monoastro/godspeed/extras/5f075b080c7758b0ab2cda3ce8750554.jpg

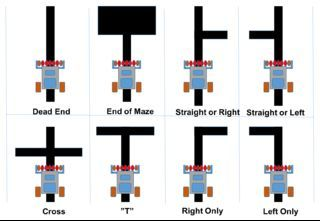
extras/5f075b080c7758b0ab2cda3ce8750554.jpg
