monoastro/godspeed/extras/Capture-3.webp

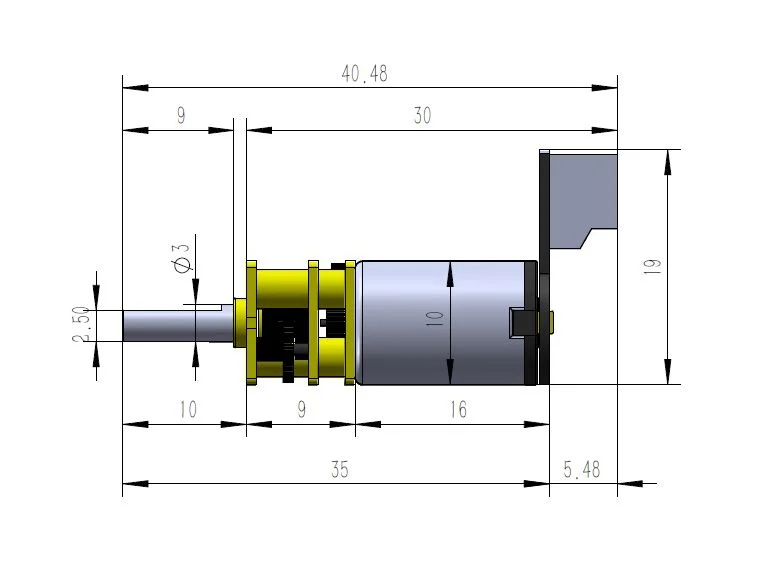
extras/Capture-3.webp
