monoastro/godspeed/extras/N20-micro-gear-motor-dimensions.webp

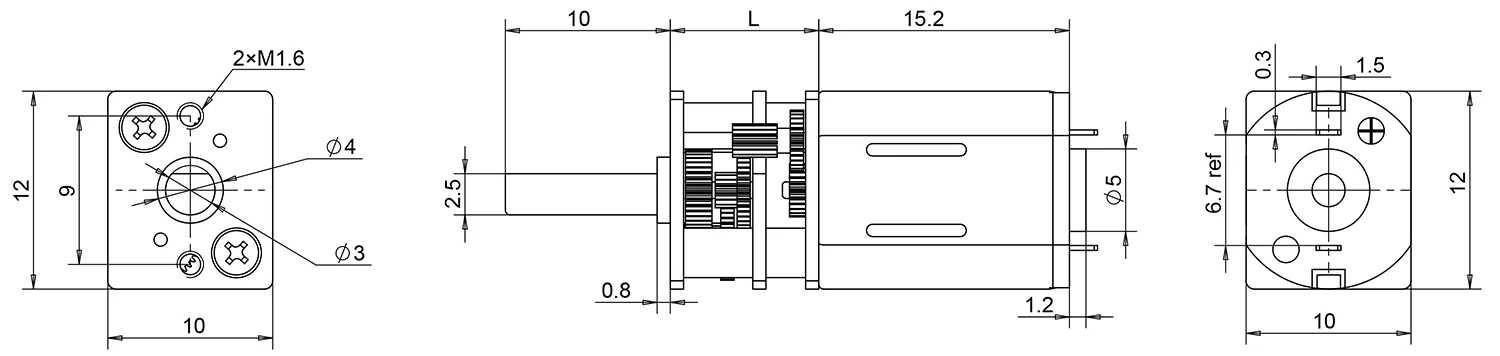
extras/N20-micro-gear-motor-dimensions.webp
