monoastro/godspeed/extras/premium-n20-gear-motor-501-ratio-460-rpm-w--encoder-dime.jpg

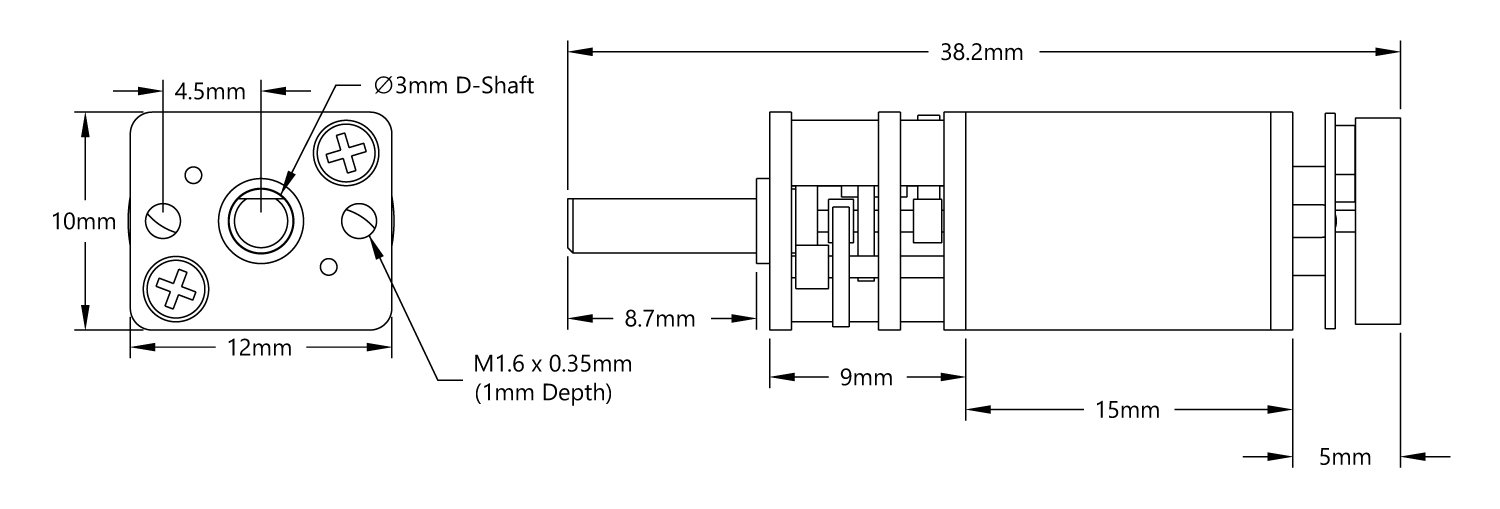
extras/premium-n20-gear-motor-501-ratio-460-rpm-w--encoder-dime.jpg
