monoastro/godspeed/extras/cost estimation final.xlsx

Sheet: Sheet1
Name of the Components | Quantity | Price per unit | Total Price
40 Amp BLDC Esc | 5 | 1100 | 5500
10 inch drone propeller | 10 | 120 | 1200
Flysky 6 channel reciever | 5 | 1000 | 5000
Servo tester | 5 | 300 | 1500
3s Li-po Battery 12V (2200 mAh) | 2 | 4500 | 9000
3s Li-po Battery 12V (3300 mAh) | 3 | 5000 | 15000
SG 90 Micro servo motor | 12 | 270 | 3240
MG90s metal gear mini servo motor | 15 | 415 | 6225
MG996s metal gear mini servo motor | 3 | 700 | 2100
Arduino Nano with connector | 10 | 850 | 8500
ESP 32 s3 with connector | 5 | 950 | 4750
Micro N20 gear mmotor (300 rpm) with wheel | 15 | 500 | 7500
12V DC gear motor (500 rpm) | 5 | 600 | 3000
12V DC gear motor (500 rpm) with 10 cm(diamter)wheels for this motor | 8 | 250 | 2000
12V DC gear motor (500 rpm) with motor mount | 10 | 150 | 1500
L298N motor Driver | 6 | 300 | 1800
Brushed ESC (for DC motor) | 2 | 2000 | 4000
Female to Female jumper wire | 1 | 230 | 230
Male to female jumper wire | 1 | 230 | 230
12 V micro cooling fan | 5 | 300 | 1500
Brushless DC motor(1400KV) | 3 | 1300 | 3900
60 amp BLDC Esc | 2 | 2000 | 4000
Heat Shrink | 2 | 120 | 240
Carbon Fibre rod (8mm diameter) 5 meter | 5 | 1400 | 7000
Nichrome Wire (4 meter) | 4 | 350 | 1400
CNY 70 IR sensor | 15 | 80 | 1200
18650 Li-ion battery | 12 | 250 | 3000
Extender wire | 5 | 300 | 1500
Arduino uno with connector | 5 | 900 | 4500
40 Amp BLDC Hobbywing | 3 | 2100 | 6300
Fibre reinforced tape | 2 | 700 | 1400
Li-po charger imax b6 | 1 | 4000 | 4000
REES52 flysky dataline cable access wiring connecting | 2 | 2500 | 5000
 |  | Total | 127215

Sheet: Sheet2
Name of the Components | Quantity | Price per unit | Total Price
40 Amp BLDC Esc | 5 | 1200 | 6000
Flysky 6 channel reciever | 3 | 2200 | 6600
3s Li-po Battery 12V (2200 mAh) | 2 | 4500 | 9000
SG 90 Micro servo motor | 6 | 270 | 1620
MG90s metal gear mini servo motor | 6 | 415 | 2490
MG996s metal gear mini servo motor | 3 | 700 | 2100
Arduino Nano with connector | 10 | 550 | 5500
Micro N20 gear mmotor (300 rpm) with wheel | 15 | 500 | 7500
12V DC gear motor (500 rpm) | 5 | 600 | 3000
12V DC gear motor (500 rpm) with 10 cm(diamter)wheels for this motor | 8 | 250 | 2000
Flysy transmtter i6s | 1 | 12000 | 12000
12V DC gear motor (500 rpm) with motor mount | 10 | 150 | 1500
L298N motor Driver | 6 | 300 | 1800
Brushed ESC (for DC motor) | 2 | 2000 | 4000
Female to Female jumper wire | 1 | 230 | 230
Male to female jumper wire | 1 | 230 | 230
12 V micro cooling fan | 3 | 300 | 900
Brushless DC motor(1400KV) | 3 | 1300 | 3900
Heat Shrink | 2 | 120 | 240
Carbon Fibre rod (8mm diameter) 5 meter | 3 | 1400 | 4200
Nichrome Wire (4 meter) | 4 | 350 | 1400
CNY 70 IR sensor | 15 | 80 | 1200
18650 Li-ion battery | 12 | 250 | 3000
Extender wire | 5 | 300 | 1500
Fibre reinforced tape | 2 | 700 | 1400
REES52 flysky dataline cable access wiring connecting | 2 | 2500 | 5000
Esp 32 s3 | 2 | 1000 | 2000
 |  | Total | 90310
Meshmerize specific
bluepill | 1
stlinkv2 dongle | 1
tb6612 motor driver | 2
N20 12V 300rpm motors with encoders | 4
wheels and brackets for N20 | 4
steel ball castor wheel | 2
hc06 bluetooth module | 1
Light Strong Rod(40 cm)(can be carbon fiber/aluminium) | 4
cny70 Ir sensor | 15
5mm ir transmitter and receiver led | 10
18650 Lion battery | 6
3s Lion Battery holder | 2
Jumper wires | 100
3s 12.6V Li-ion Bms | 2
7805 voltage regulator | 2
Solder wire roll | 2
Breadboard | 3
12 V 3s lipo | 1
Resistor and Capacitor Box | 1
Female Header | 6
Ribbon Cable | 1
buck-boost converter | 2
