monoastro/godspeed/extras/meshmerize.pdf

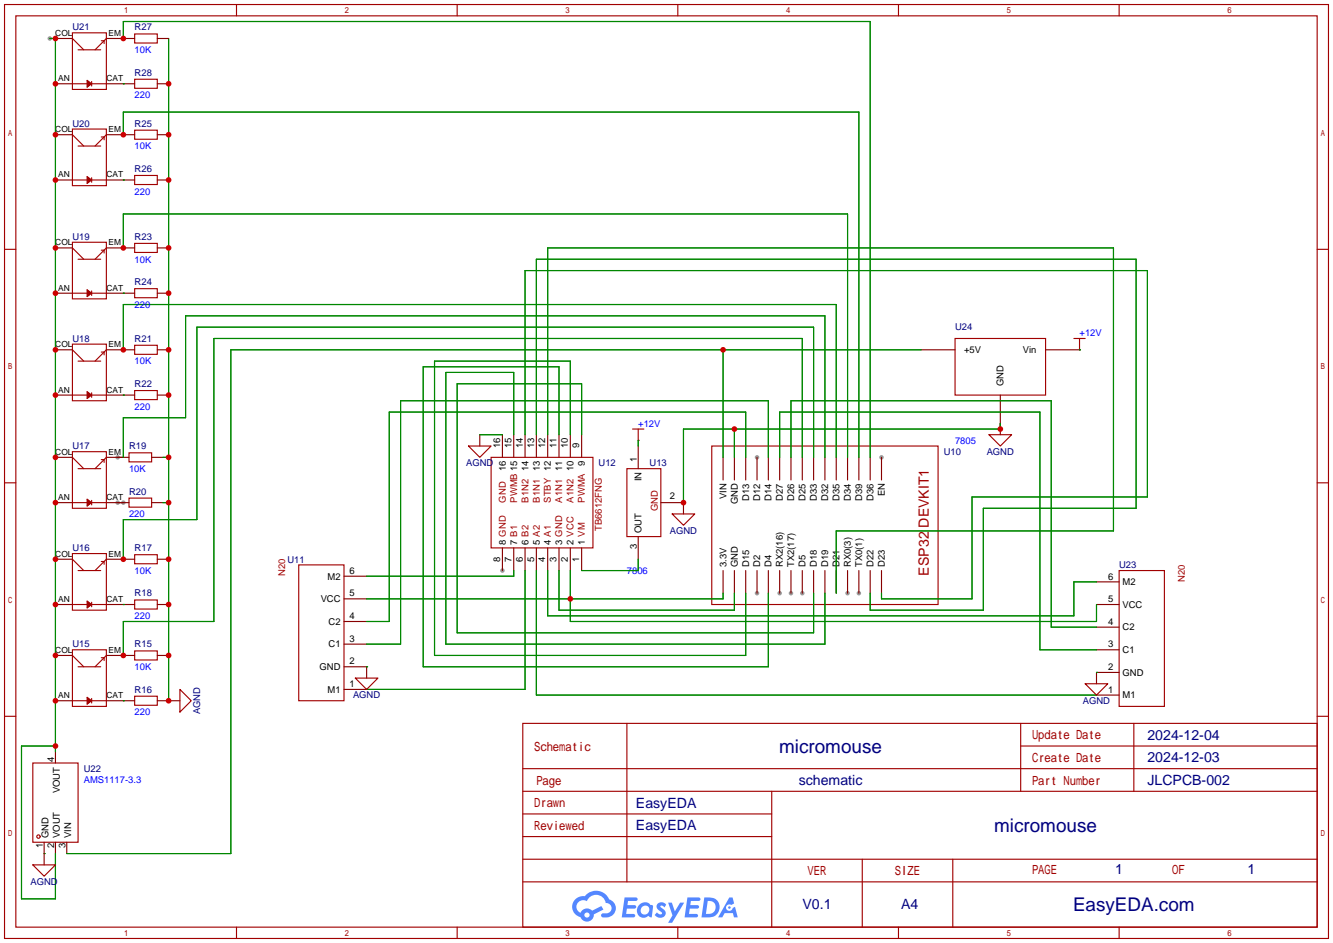
[picture p53: page 1]
