monoastro/godspeed/(commit log)

2024-12-12 PID testing website
2024-12-15 updated struct
    [cost estimation final.xlsx]
